girishji/keychron-optical-keyboard/resources/keychronpic.png

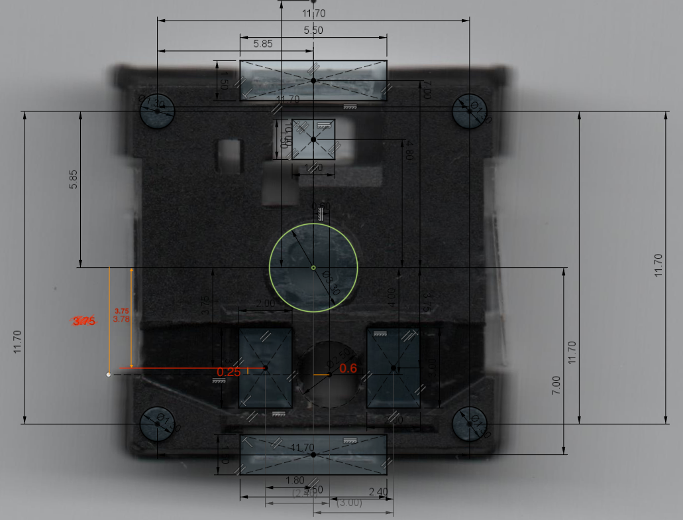
resources/keychronpic.png
