girishji/keychron-optical-keyboard/resources/IMG_0621.JPG

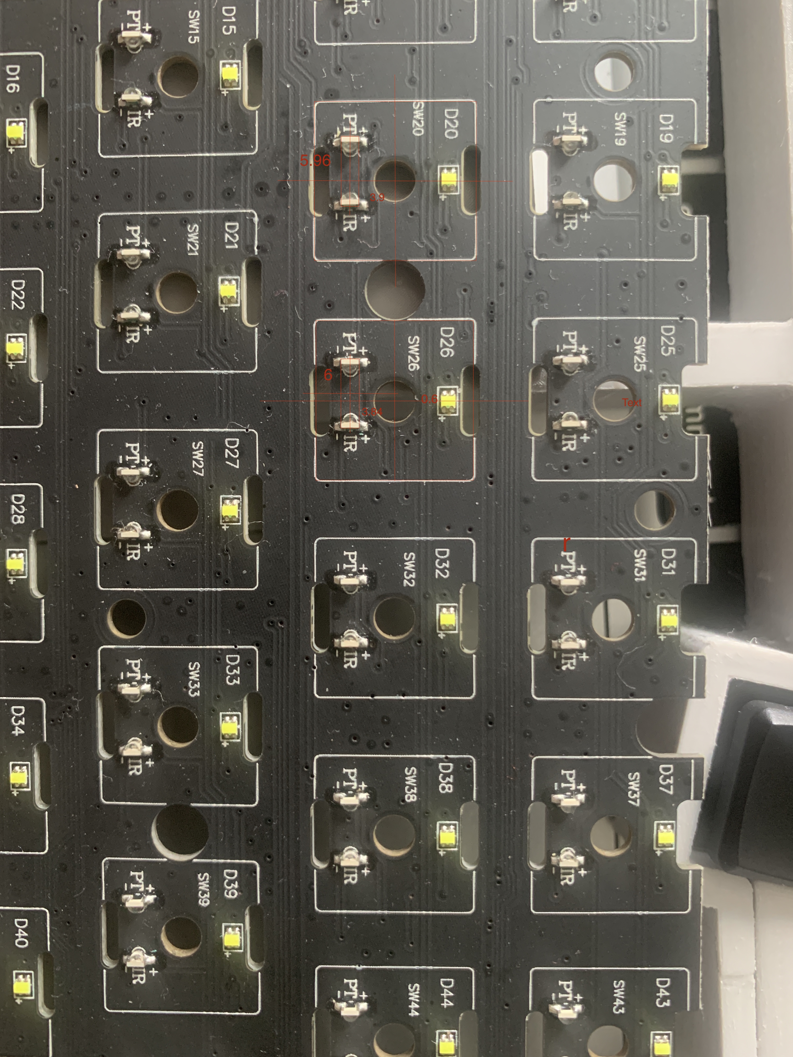
resources/IMG_0621.JPG
