girishji/keychron-optical-keyboard/README.md

# Keychron Low-Pro Optical Keyboard
Keyboard PCB in KiCad using Keychron low-profile optical switches, with some ergonomic sugar and integrated wrist rest.

PCB
