girishji/keychron-optical-keyboard/keychron-optical-keyboard.kicad_pcb

## KiCad design keychron-optical-keyboard.kicad_pcb (2022-08-17)

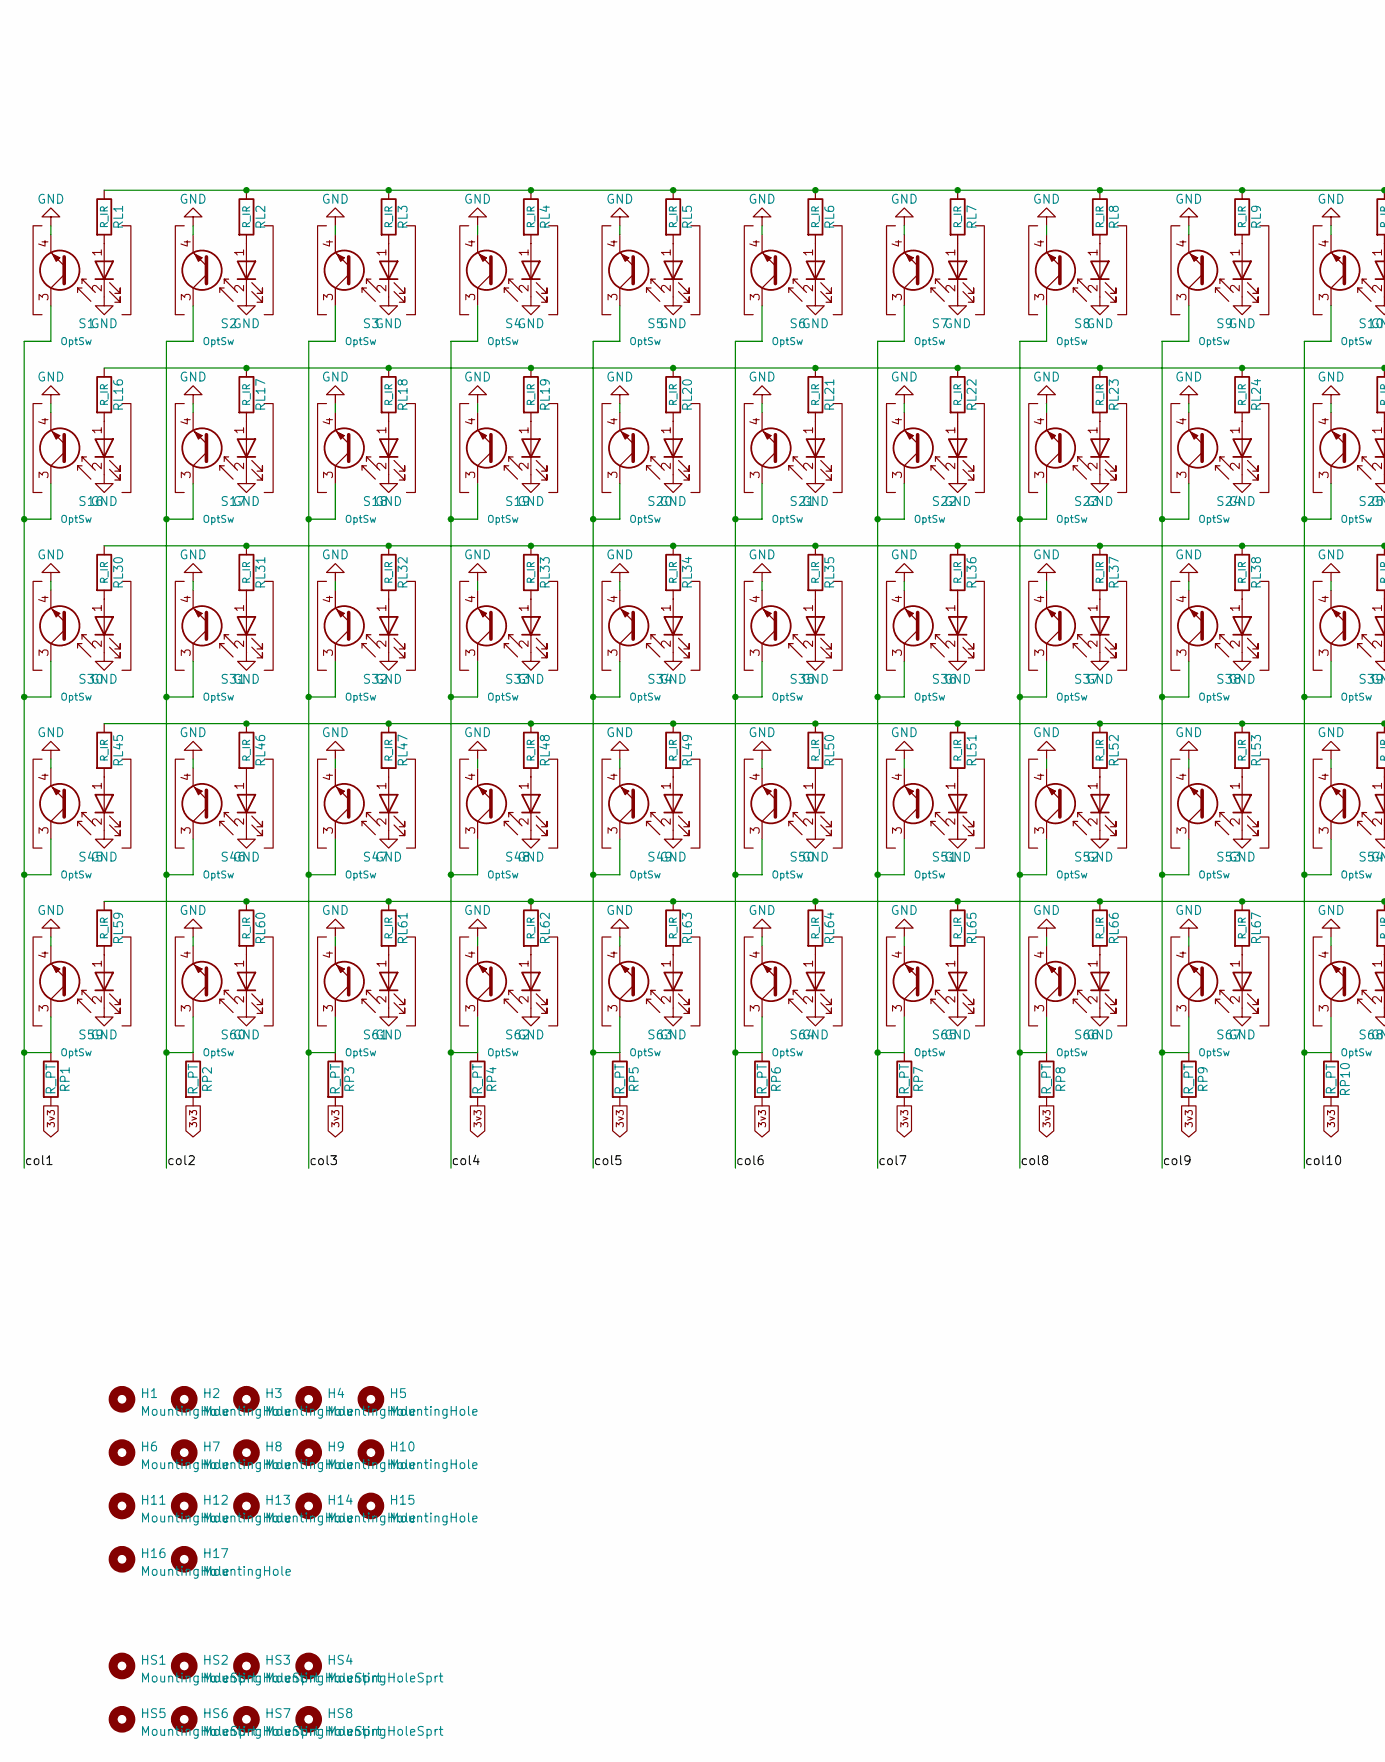
[picture p3: schematic keychron-optical-keyboard.kicad_sch, part in row 1, column 1]

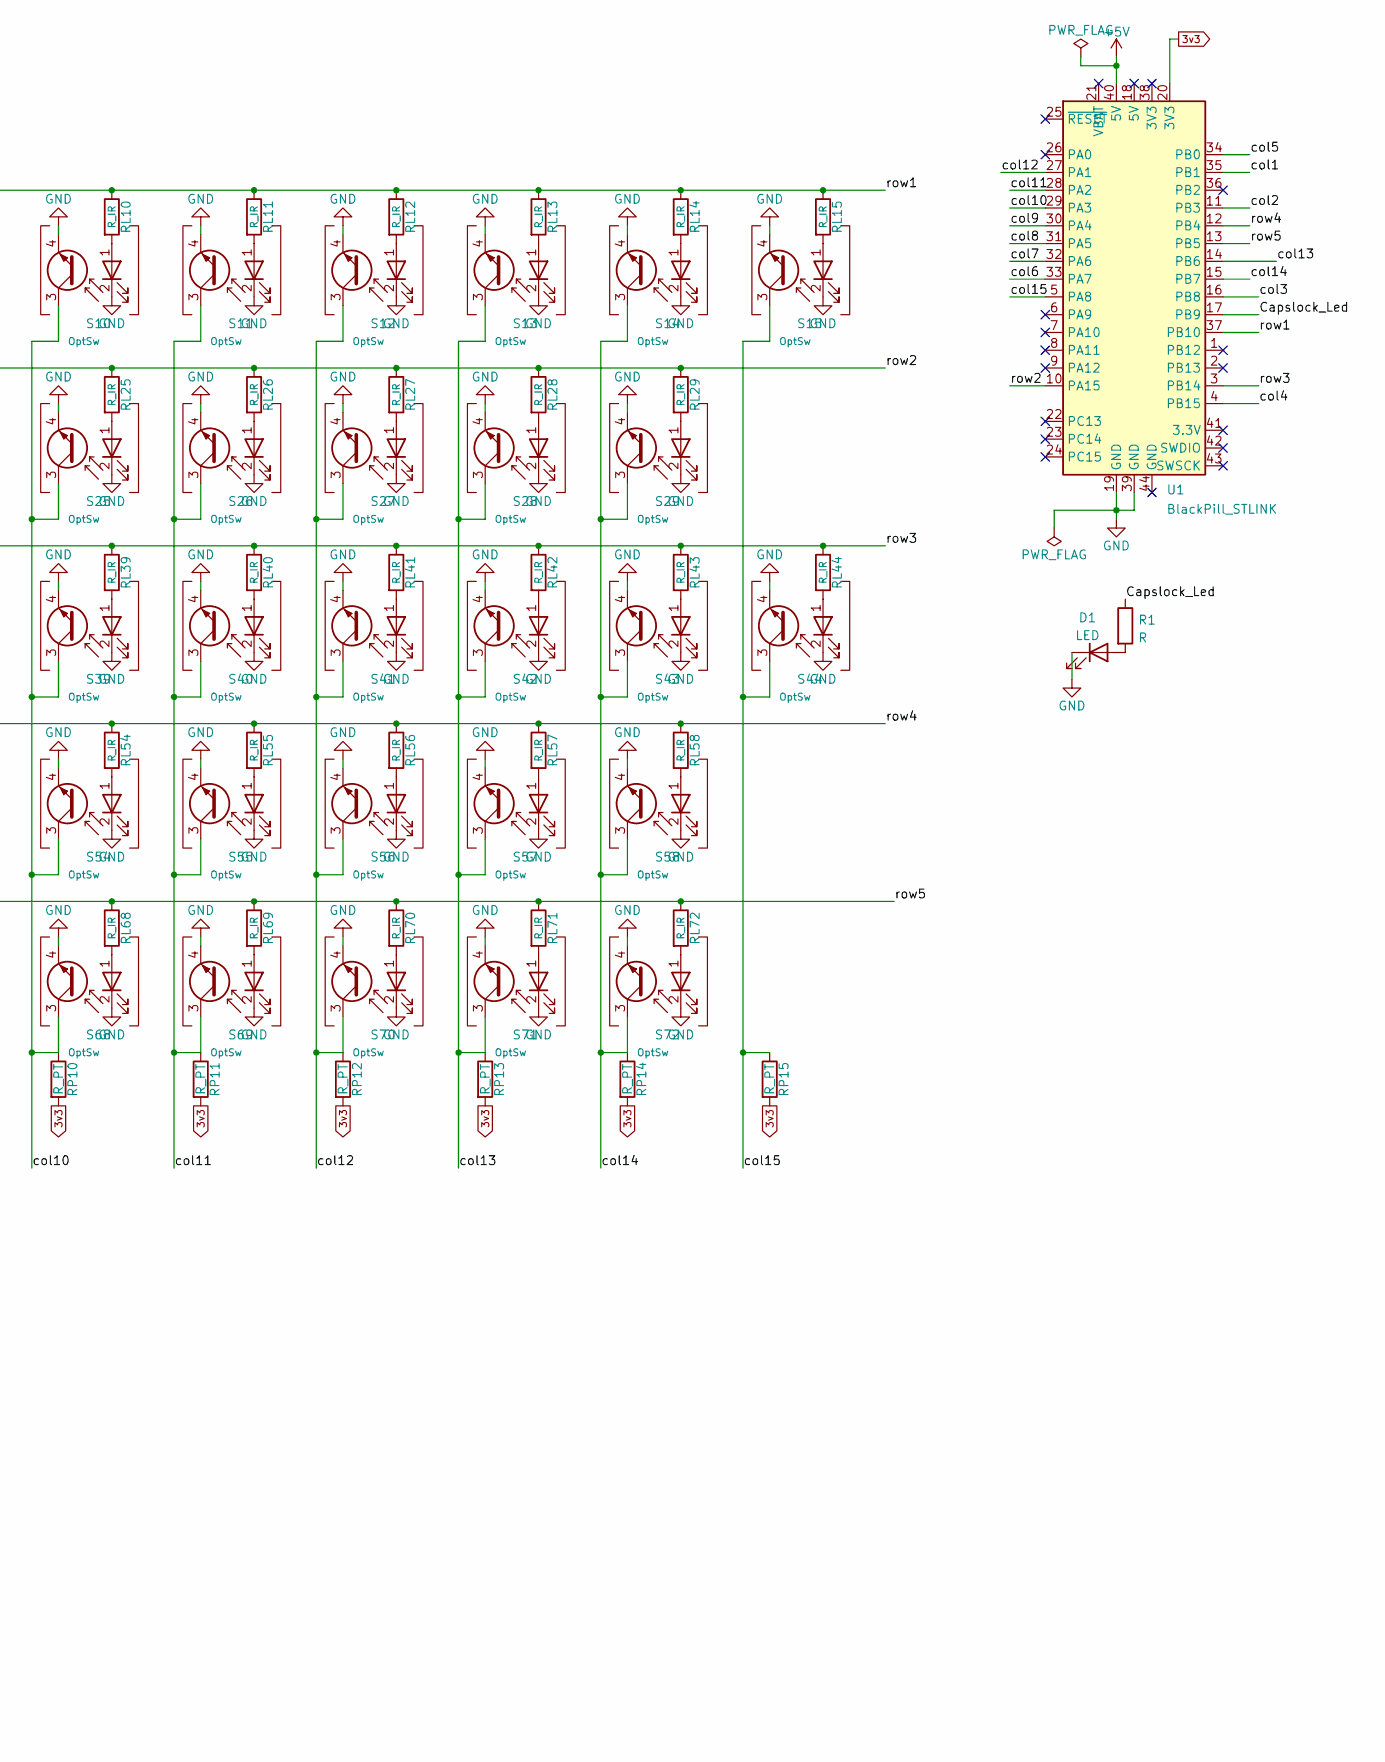
[picture p4: schematic keychron-optical-keyboard.kicad_sch, part in row 1, column 2]

Parts:
D1: LED; LED_0603_1608Metric_Pad1.05x0.95mm_HandSolder
H1, H2, H3, H4, H5, H6, H7, H8, H9, H10, H11, H12, H13, H14, H15, H16, H17: MountingHole; SMTSO_M1.6
HS1, HS2, HS3, HS4, HS5, HS6, HS7, HS8: MountingHoleSprt; SMTSO_M2
R1: R; R_0805_2012Metric_Pad1.20x1.40mm_HandSolder
RL1: R_IR; R_0805_2012Metric_Pad1.20x1.40mm_HandSolder
RL2, RL3, RL4, RL5, RL6, RL7, RL8, RL9, RL10, RL11, RL12, RL13, RL14, RL15, RL16, RL17, RL18, RL19, RL20, RL21, RL22, RL23, RL24, RL25, RL26, RL27, RL28, RL29, RL30, RL31, RL32, RL33, RL34, RL35, RL36, RL37, RL38, RL39, RL40, RL41, RL42, RL43, RL44, RL45, RL46, RL47, RL48, RL49, RL50, RL51, RL52, RL53, RL54, RL55, RL56, RL57, RL58, RL59, RL60, RL61, RL62, RL63, RL64, RL65, RL66, RL67, RL68, RL69, RL70, RL71, RL72: R_IR; R_0805_2012Metric_Pad1.20x1.40mm_HandSolder; JLC 0603-1608
RP1, RP2, RP3, RP4, RP5, RP6, RP7, RP8, RP9, RP10, RP11, RP12, RP13, RP14, RP15: R_PT; R_0805_2012Metric_Pad1.20x1.40mm_HandSolder; JLC 0805-2012
S1, S2, S3, S4, S5, S6, S7, S8, S9, S10, S11, S12, S13, S14, S15, S17, S18, S19, S20, S21, S22, S23, S24, S25, S26, S27, S28, S30, S31, S32, S33, S34, S35, S36, S37, S38, S39, S40, S41, S42, S44, S46, S47, S48, S49, S50, S51, S52, S53, S54, S55, S56, S58, S59, S60, S61, S62, S65, S67, S68, S69, S70, S71, S72: OptSw; Keychron_Optical_Switch_1u
S16, S29, S45: OptSw; Keychron_Optical_Switch_1.5u
S43, S57, S63, S64, S66: OptSw; Keychron_Optical_Switch_1.25u
U1: BlackPill_STLINK; BlackPill_STLINK_Down

Connections:
3v3: RP1.2, RP2.2, RP3.2, RP4.2, RP5.2, RP6.2, RP7.2, RP8.2, RP9.2, RP10.2, RP11.2, RP12.2, RP13.2, RP14.2, RP15.2, U1.20 (3V3)
+5V: U1.40 (5V)
/Capslock_Led: R1.1, U1.17 (PB9)
/col1: RP1.1, S1.3 (C), S16.3 (C), S30.3 (C), S45.3 (C), S59.3 (C), U1.35 (PB1)
/col2: RP2.1, S2.3 (C), S17.3 (C), S31.3 (C), S46.3 (C), S60.3 (C), U1.11 (PB3)
/col3: RP3.1, S3.3 (C), S18.3 (C), S32.3 (C), S47.3 (C), S61.3 (C), U1.16 (PB8)
/col4: RP4.1, S4.3 (C), S19.3 (C), S33.3 (C), S48.3 (C), S62.3 (C), U1.4 (PB15)
/col5: RP5.1, S5.3 (C), S20.3 (C), S34.3 (C), S49.3 (C), S63.3 (C), U1.34 (PB0)
/col6: RP6.1, S6.3 (C), S21.3 (C), S35.3 (C), S50.3 (C), S64.3 (C), U1.33 (PA7)
/col7: RP7.1, S7.3 (C), S22.3 (C), S36.3 (C), S51.3 (C), S65.3 (C), U1.32 (PA6)
/col8: RP8.1, S8.3 (C), S23.3 (C), S37.3 (C), S52.3 (C), S66.3 (C), U1.31 (PA5)
/col9: RP9.1, S9.3 (C), S24.3 (C), S38.3 (C), S53.3 (C), S67.3 (C), U1.30 (PA4)
/col10: RP10.1, S10.3 (C), S25.3 (C), S39.3 (C), S54.3 (C), S68.3 (C), U1.29 (PA3)
/col11: RP11.1, S11.3 (C), S26.3 (C), S40.3 (C), S55.3 (C), S69.3 (C), U1.28 (PA2)
/col12: RP12.1, S12.3 (C), S27.3 (C), S41.3 (C), S56.3 (C), S70.3 (C), U1.27 (PA1)
/col13: RP13.1, S13.3 (C), S28.3 (C), S42.3 (C), S57.3 (C), S71.3 (C), U1.14 (PB6)
/col14: RP14.1, S14.3 (C), S29.3 (C), S43.3 (C), S58.3 (C), S72.3 (C), U1.15 (PB7)
/col15: RP15.1, S15.3 (C), S44.3 (C), U1.5 (PA8)
/row1: RL1.1, RL2.1, RL3.1, RL4.1, RL5.1, RL6.1, RL7.1, RL8.1, RL9.1, RL10.1, RL11.1, RL12.1, RL13.1, RL14.1, RL15.1, U1.37 (PB10)
/row2: RL16.1, RL17.1, RL18.1, RL19.1, RL20.1, RL21.1, RL22.1, RL23.1, RL24.1, RL25.1, RL26.1, RL27.1, RL28.1, RL29.1, U1.10 (PA15)
/row3: RL30.1, RL31.1, RL32.1, RL33.1, RL34.1, RL35.1, RL36.1, RL37.1, RL38.1, RL39.1, RL40.1, RL41.1, RL42.1, RL43.1, RL44.1, U1.3 (PB14)
/row4: RL45.1, RL46.1, RL47.1, RL48.1, RL49.1, RL50.1, RL51.1, RL52.1, RL53.1, RL54.1, RL55.1, RL56.1, RL57.1, RL58.1, U1.12 (PB4)
/row5: RL59.1, RL60.1, RL61.1, RL62.1, RL63.1, RL64.1, RL65.1, RL66.1, RL67.1, RL68.1, RL69.1, RL70.1, RL71.1, RL72.1, U1.13 (PB5)
GND: D1.1 (K), S1.2 (IR_K), S1.4 (E), S2.2 (IR_K), S2.4 (E), S3.2 (IR_K), S3.4 (E), S4.2 (IR_K), S4.4 (E), S5.2 (IR_K), S5.4 (E), S6.2 (IR_K), S6.4 (E), S7.2 (IR_K), S7.4 (E), S8.2 (IR_K), S8.4 (E), S9.2 (IR_K), S9.4 (E), S10.2 (IR_K), S10.4 (E), S11.2 (IR_K), S11.4 (E), S12.2 (IR_K), S12.4 (E), S13.2 (IR_K), S13.4 (E), S14.2 (IR_K), S14.4 (E), S15.2 (IR_K), S15.4 (E), S16.2 (IR_K), S16.4 (E), S17.2 (IR_K), S17.4 (E), S18.2 (IR_K), S18.4 (E), S19.2 (IR_K), S19.4 (E), S20.2 (IR_K), S20.4 (E), S21.2 (IR_K), S21.4 (E), S22.2 (IR_K), S22.4 (E), S23.2 (IR_K), S23.4 (E), S24.2 (IR_K), S24.4 (E), S25.2 (IR_K), S25.4 (E), S26.2 (IR_K), S26.4 (E), S27.2 (IR_K), S27.4 (E), S28.2 (IR_K), S28.4 (E), S29.2 (IR_K), S29.4 (E), S30.2 (IR_K), S30.4 (E), S31.2 (IR_K), S31.4 (E), S32.2 (IR_K), S32.4 (E), S33.2 (IR_K), S33.4 (E), S34.2 (IR_K), S34.4 (E), S35.2 (IR_K), S35.4 (E), S36.2 (IR_K), S36.4 (E), S37.2 (IR_K), S37.4 (E), S38.2 (IR_K), S38.4 (E), S39.2 (IR_K), S39.4 (E), S40.2 (IR_K), S40.4 (E), S41.2 (IR_K), S41.4 (E), S42.2 (IR_K), S42.4 (E), S43.2 (IR_K), S43.4 (E), S44.2 (IR_K), S44.4 (E), S45.2 (IR_K), S45.4 (E), S46.2 (IR_K), S46.4 (E), S47.2 (IR_K), S47.4 (E), S48.2 (IR_K), S48.4 (E), S49.2 (IR_K), S49.4 (E), S50.2 (IR_K), S50.4 (E), S51.2 (IR_K), S51.4 (E), S52.2 (IR_K), S52.4 (E), S53.2 (IR_K), S53.4 (E), S54.2 (IR_K), S54.4 (E), S55.2 (IR_K), S55.4 (E), S56.2 (IR_K), S56.4 (E), S57.2 (IR_K), S57.4 (E), S58.2 (IR_K), S58.4 (E), S59.2 (IR_K), S59.4 (E), S60.2 (IR_K), S60.4 (E), S61.2 (IR_K), S61.4 (E), S62.2 (IR_K), S62.4 (E), S63.2 (IR_K), S63.4 (E), S64.2 (IR_K), S64.4 (E), S65.2 (IR_K), S65.4 (E), S66.2 (IR_K), S66.4 (E), S67.2 (IR_K), S67.4 (E), S68.2 (IR_K), S68.4 (E), S69.2 (IR_K), S69.4 (E), S70.2 (IR_K), S70.4 (E), S71.2 (IR_K), S71.4 (E), S72.2 (IR_K), S72.4 (E), U1.19 (GND), U1.39 (GND)
unnamed: D1.2 (A), R1.2
unnamed: RL1.2, S1.1 (IR_A)
unnamed: RL2.2, S2.1 (IR_A)
unnamed: RL3.2, S3.1 (IR_A)
unnamed: RL4.2, S4.1 (IR_A)
unnamed: RL5.2, S5.1 (IR_A)
unnamed: RL6.2, S6.1 (IR_A)
unnamed: RL7.2, S7.1 (IR_A)
unnamed: RL8.2, S8.1 (IR_A)
unnamed: RL9.2, S9.1 (IR_A)
unnamed: RL10.2, S10.1 (IR_A)
unnamed: RL11.2, S11.1 (IR_A)
unnamed: RL12.2, S12.1 (IR_A)
unnamed: RL13.2, S13.1 (IR_A)
unnamed: RL14.2, S14.1 (IR_A)
unnamed: RL15.2, S15.1 (IR_A)
unnamed: RL16.2, S16.1 (IR_A)
unnamed: RL17.2, S17.1 (IR_A)
unnamed: RL18.2, S18.1 (IR_A)
unnamed: RL19.2, S19.1 (IR_A)
unnamed: RL20.2, S20.1 (IR_A)
unnamed: RL21.2, S21.1 (IR_A)
unnamed: RL22.2, S22.1 (IR_A)
unnamed: RL23.2, S23.1 (IR_A)
unnamed: RL24.2, S24.1 (IR_A)
unnamed: RL25.2, S25.1 (IR_A)
unnamed: RL26.2, S26.1 (IR_A)
unnamed: RL27.2, S27.1 (IR_A)
unnamed: RL28.2, S28.1 (IR_A)
unnamed: RL29.2, S29.1 (IR_A)
unnamed: RL30.2, S30.1 (IR_A)
unnamed: RL31.2, S31.1 (IR_A)
unnamed: RL32.2, S32.1 (IR_A)
unnamed: RL33.2, S33.1 (IR_A)
unnamed: RL34.2, S34.1 (IR_A)
unnamed: RL35.2, S35.1 (IR_A)
unnamed: RL36.2, S36.1 (IR_A)
unnamed: RL37.2, S37.1 (IR_A)
unnamed: RL38.2, S38.1 (IR_A)
unnamed: RL39.2, S39.1 (IR_A)
unnamed: RL40.2, S40.1 (IR_A)
unnamed: RL41.2, S41.1 (IR_A)
unnamed: RL42.2, S42.1 (IR_A)
unnamed: RL43.2, S43.1 (IR_A)
unnamed: RL44.2, S44.1 (IR_A)
unnamed: RL45.2, S45.1 (IR_A)
unnamed: RL46.2, S46.1 (IR_A)
unnamed: RL47.2, S47.1 (IR_A)
unnamed: RL48.2, S48.1 (IR_A)
unnamed: RL49.2, S49.1 (IR_A)
unnamed: RL50.2, S50.1 (IR_A)
unnamed: RL51.2, S51.1 (IR_A)
unnamed: RL52.2, S52.1 (IR_A)
unnamed: RL53.2, S53.1 (IR_A)
unnamed: RL54.2, S54.1 (IR_A)
unnamed: RL55.2, S55.1 (IR_A)
unnamed: RL56.2, S56.1 (IR_A)
unnamed: RL57.2, S57.1 (IR_A)
unnamed: RL58.2, S58.1 (IR_A)
unnamed: RL59.2, S59.1 (IR_A)
unnamed: RL60.2, S60.1 (IR_A)
unnamed: RL61.2, S61.1 (IR_A)
unnamed: RL62.2, S62.1 (IR_A)
unnamed: RL63.2, S63.1 (IR_A)
unnamed: RL64.2, S64.1 (IR_A)
unnamed: RL65.2, S65.1 (IR_A)
unnamed: RL66.2, S66.1 (IR_A)
unnamed: RL67.2, S67.1 (IR_A)
unnamed: RL68.2, S68.1 (IR_A)
unnamed: RL69.2, S69.1 (IR_A)
unnamed: RL70.2, S70.1 (IR_A)
unnamed: RL71.2, S71.1 (IR_A)
unnamed: RL72.2, S72.1 (IR_A)

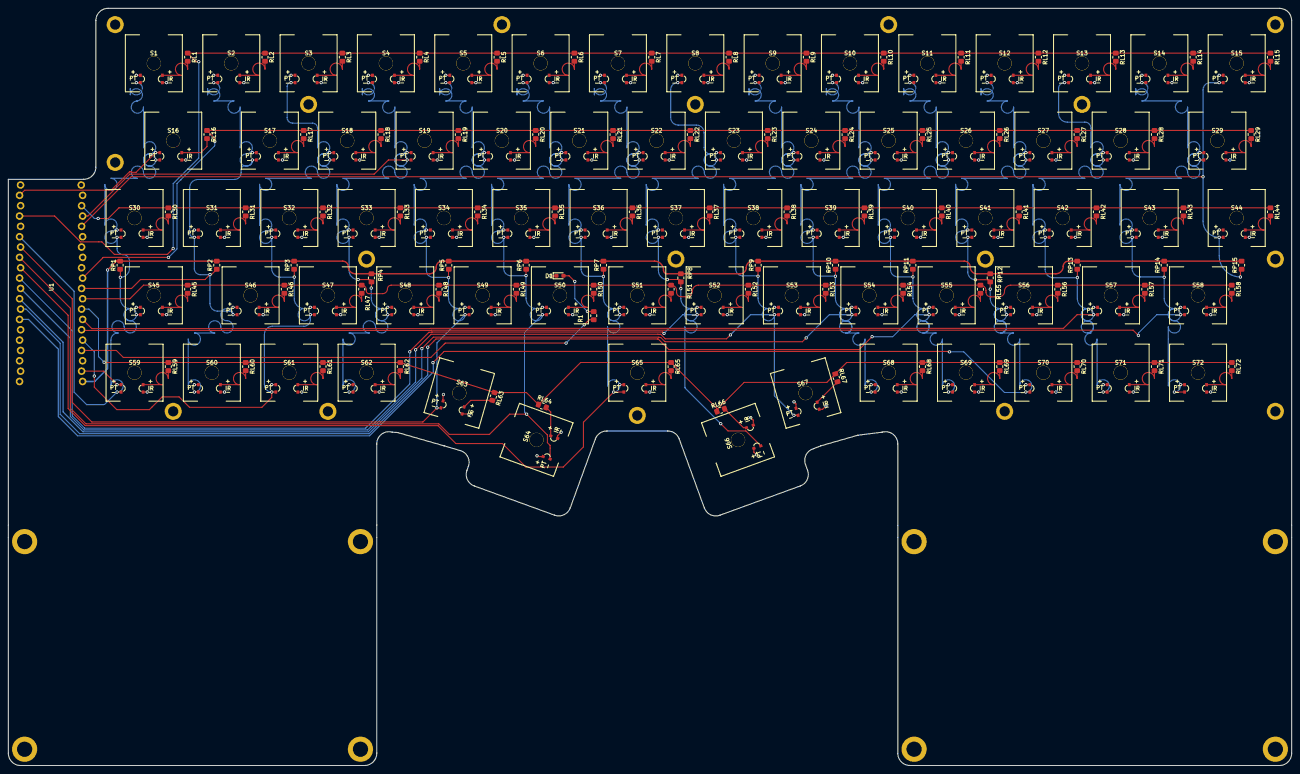
[picture p5: board keychron-optical-keyboard.kicad_pcb from above]

Board: 2 copper layers, 315.2 x 186.0 mm, 187 parts (0 on the bottom side), 96 nets.
