girishji/keychron-optical-keyboard/(threads)

Thread 1 (2022-10-12):

What is the proper thickness of the PCB and switch plate?

myst729, 2022-10-12:
Is it 1.6mm or 1.0mm? Thanks.

girishji, 2022-11-06:
switch plate is 1.2mm. pcb can be any thickness, but 1.2 or 1.6mm should work

Closed 2022-10-19.

Thread 2 (2025-01-07):

Sourcing Components

superami-code, 2025-01-07:
I was working on my own design and the issue I keep having is sourcing a small enough IR Emitter/Transistor pair. This pair is one of the only I have found, but I can't seem to find a source to actually get a hold of them. Do you have a source?

superami-code, 2025-01-08:
I'm in Germany. That is perfect. I had been checking DigiKey and Mouser, and hadn't found them. Even now I am not finding the Allight S0602PTB or S0602IRC on any of those platforms. I've tried searching side view IR, phototransistors and nothing seems to come up.

Did you use a different part?

girishji, 2025-01-12:
What switch are you using? Also, try farnell and TME in EU. I had no problem sourcing any of the sideview IR or PTs in Poland. If you get pcb made through jlcpcb then they have IR and PTs too. You can even find them on aliexpress.
I generally use these (search for these codes):
PT26-61/IR26-61 - 1.2mm height, 3.0 width suitable for gateron
PT26-51/IR26-51 - 1.6mm height suitable for Kailh

superami-code, 2025-01-13:
From the layout I thought you were using the low-profile KeyChron switches, and based on the 3mm width, it would seem those would be too tight to fit reliably.

girishji, 2025-01-13:
Ah, yes. I have so many keyboards I forgot. You can email Allight directly and they'll will sell directly to consumers.
Aliexpress has generic ones (not Allight).

https://pl.aliexpress.com/item/1005008129660052.html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

https://pl.aliexpress.com/item/1005008287204819.html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

superami-code, 2025-01-14:
I had found the second of those two listings, but there is no indication of the quantity.

Related question, do you know if the IR12-21C types will fit in the low profile. They are much easier to come by, even in small quantities.

They would seem to be small enough to fit, but without much tolerance for placement.

superami-code, 2025-01-14:
Thank you btw, for the feed back.

girishji, 2025-01-14:
> IR12-21C

They do not fit.

Closed 2025-01-26.
