girishji/keychron-optical-keyboard/(commit log)

2022-08-03 Add schematic for keyboard and footprints
    M .gitignore
    A Footprints.pretty/BlackPill_STLINK2.kicad_mod
    A Footprints.pretty/IR12-21C_TR8.kicad_mod
    A Footprints.pretty/Keychron_LP_Optical.kicad_mod
    A Footprints.pretty/Keychron_Optical_Switch_1.25u.kicad_mod
    A Footprints.pretty/Keychron_Optical_Switch_1.5u.kicad_mod
    A Footprints.pretty/Keychron_Optical_Switch_1.75u.kicad_mod
    A Footprints.pretty/Keychron_Optical_Switch_1u.kicad_mod
    A Footprints.pretty/Keychron_Optical_Switch_2u.kicad_mod
    A Footprints.pretty/MountingHole_1.2mm_M1.kicad_mod
    A Footprints.pretty/MountingHole_2.2mm_M2.kicad_mod
    A Footprints.pretty/MountingHole_2.2mm_M2_jlcpcb.kicad_mod
    A Footprints.pretty/PT12-21B_TR8.ki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
    [keychron-optical-keyboard.kicad_pcb, keychron-optical-keyboard.kicad_sch]
2022-08-05 Add footprints
    A Footprints.pretty/BlackPill_STLINK.kicad_mod
    M Footprints.pretty/BlackPill_STLINK2.kicad_mod
    M Footprints.pretty/Keychron_Optical_Switch_1.25u.kicad_mod
    M Footprints.pretty/Keychron_Optical_Switch_1.5u.kicad_mod
    M Footprints.pretty/Keychron_Optical_Switch_1.75u.kicad_mod
    M Footprints.pretty/Keychron_Optical_Switch_1u.kicad_mod
    M Footprints.pretty/Keychron_Optical_Switch_2u.kicad_mod
    M MySymbols.kicad_sym
    D keychron-optical-keyboard-backups/keychron-optical-keyboard-2022-08-03_201538.zip
    D keychron-optical-keyboard-backups/keychron-optical-keyboard-2022-08-03_202112.zip
    M keychron-optical-keyboard.kicad_pcb
    M keychron-optical-keyboard.kicad_prl
    M ke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
    [keychron-optical-keyboard.kicad_pcb, keychron-optical-keyboard.kicad_sch]
2022-08-15 Route tracks, add switch plate, scripts
    Add python scripts to route tracks, draw border, place footprints
    A Footprints.pretty/BlackPill_STLINK_Down.kicad_mod
    A Footprints.pretty/Border_PCB_WR.kicad_mod
    D Footprints.pretty/Keychron_Optical_Switch_1.75u.kicad_mod
    D Footprints.pretty/Keychron_Optical_Switch_2u.kicad_mod
    A Footprints.pretty/MountingHole_2.2mm_M2_ISO7380_Pad.kicad_mod
    A Footprints.pretty/SMTSO_M1.6.kicad_mod
    A Footprints.pretty/SMTSO_M2.kicad_mod
    M Footprints.pretty/Switch_Cutout.kicad_mod
    M My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
    [keychron-optical-keyboard.kicad_pcb, keychron-optical-keyboard.kicad_sch, switch-plate.kicad_pcb, switch-plate.kicad_sch]
2022-08-16 Add border to switch plate
    A Footprints.pretty/MountingHole_1.7mm_M1.6_Pad.kicad_mod
    M Footprints.pretty/MountingHole_2.2mm_M2_ISO7380_Pad.kicad_mod
    M placek.py
    M switch-plate/switch-plate.kicad_pcb
    M switch-plate/switch-plate.kicad_sch
    [switch-plate.kicad_pcb, switch-plate.kicad_sch]
2022-08-16 Add wrist support plate and remove 2 keys
    A drawborderk.py
    M keychron-optical-keyboard.kicad_pro
    M keychron-optical-keyboard.kicad_sch
    A wrist-support/.gitignore
    A wrist-support/fp-lib-table
    A wrist-support/sym-lib-table
    A wrist-support/wrist-support.kicad_pcb
    A wrist-support/wrist-support.kicad_prl
    A wrist-support/wrist-support.kicad_pro
    A wrist-support/wrist-support.kicad_sch
    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
    [keychron-optical-keyboard.kicad_pcb, keychron-optical-keyboard.kicad_sch, switch-plate.kicad_pcb, switch-plate.kicad_sch, wrist-support.kicad_pcb, wrist-support.kicad_sch]
2022-08-17 Add gerbers and assembly file
    M README.md
    A jlcpcb/gerber.zip
    A jlcpcb/gerber/keychron-optical-keyboard-B_Cu.gbl
    A jlcpcb/gerber/keychron-optical-keyboard-B_Mask.gbs
    A jlcpcb/gerber/keychron-optical-keyboard-B_Paste.gbp
    A jlcpcb/gerber/keychron-optical-keyboard-B_Silkscreen.gbo
    A jlcpcb/gerber/keychron-optical-keyboard-Edge_Cuts.gm1
    A jlcpcb/gerber/keychron-optical-keyboard-F_Cu.gtl
    A jlcpcb/gerber/keychron-optical-keyboard-F_Mask.gts
    A jlcpcb/gerber/keychron-optical-keyboard-F_Paste.gtp
    A jlcpcb/gerber/keychron-optical-keyboard-F_Silkscreen.gto
    A jlcpcb/gerber/keychron-optical-keyboard-NPTH-drl_map.gbr
    A jlcpcb/gerber/keychron-optical-keyboard-NPTH.drl
    A jlcpcb/g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
    [keychron-optical-keyboard-B_Cu.gbl, keychron-optical-keyboard-B_Mask.gbs, keychron-optical-keyboard-B_Paste.gbp, keychron-optical-keyboard-B_Silkscreen.gbo, keychron-optical-keyboard-Edge_Cuts.gm1, keychron-optical-keyboard-F_Cu.gtl, keychron-optical-keyboard-F_Mask.gts, keychron-optical-keyboard-F_Paste.gtp]
